rjperez94/AVC/README.md

# AVC

## Running the program
- Run `robotcode_PID_WithNewtworkCode.ino`

## More details
- See the [report](https://github.com/rjperez94/AVC/blob/master/Report.pdf) for complete methodology and results
